Gina417/Thermometer-Design-with-Arduino/README.md

# Thermometer-Design-with-Arduino

In this project,I design a simple Thermometer with Arduino.We could use this themometer to measure the temperature without paying any money.When the temperature is higher than 30 degree,the light will be turned on.
